samo4/PD-sniffer-237-remix/hw/FreshTwinkie.kicad_pcb

## KiCad design hw/FreshTwinkie.kicad_pcb (2023-12-09)

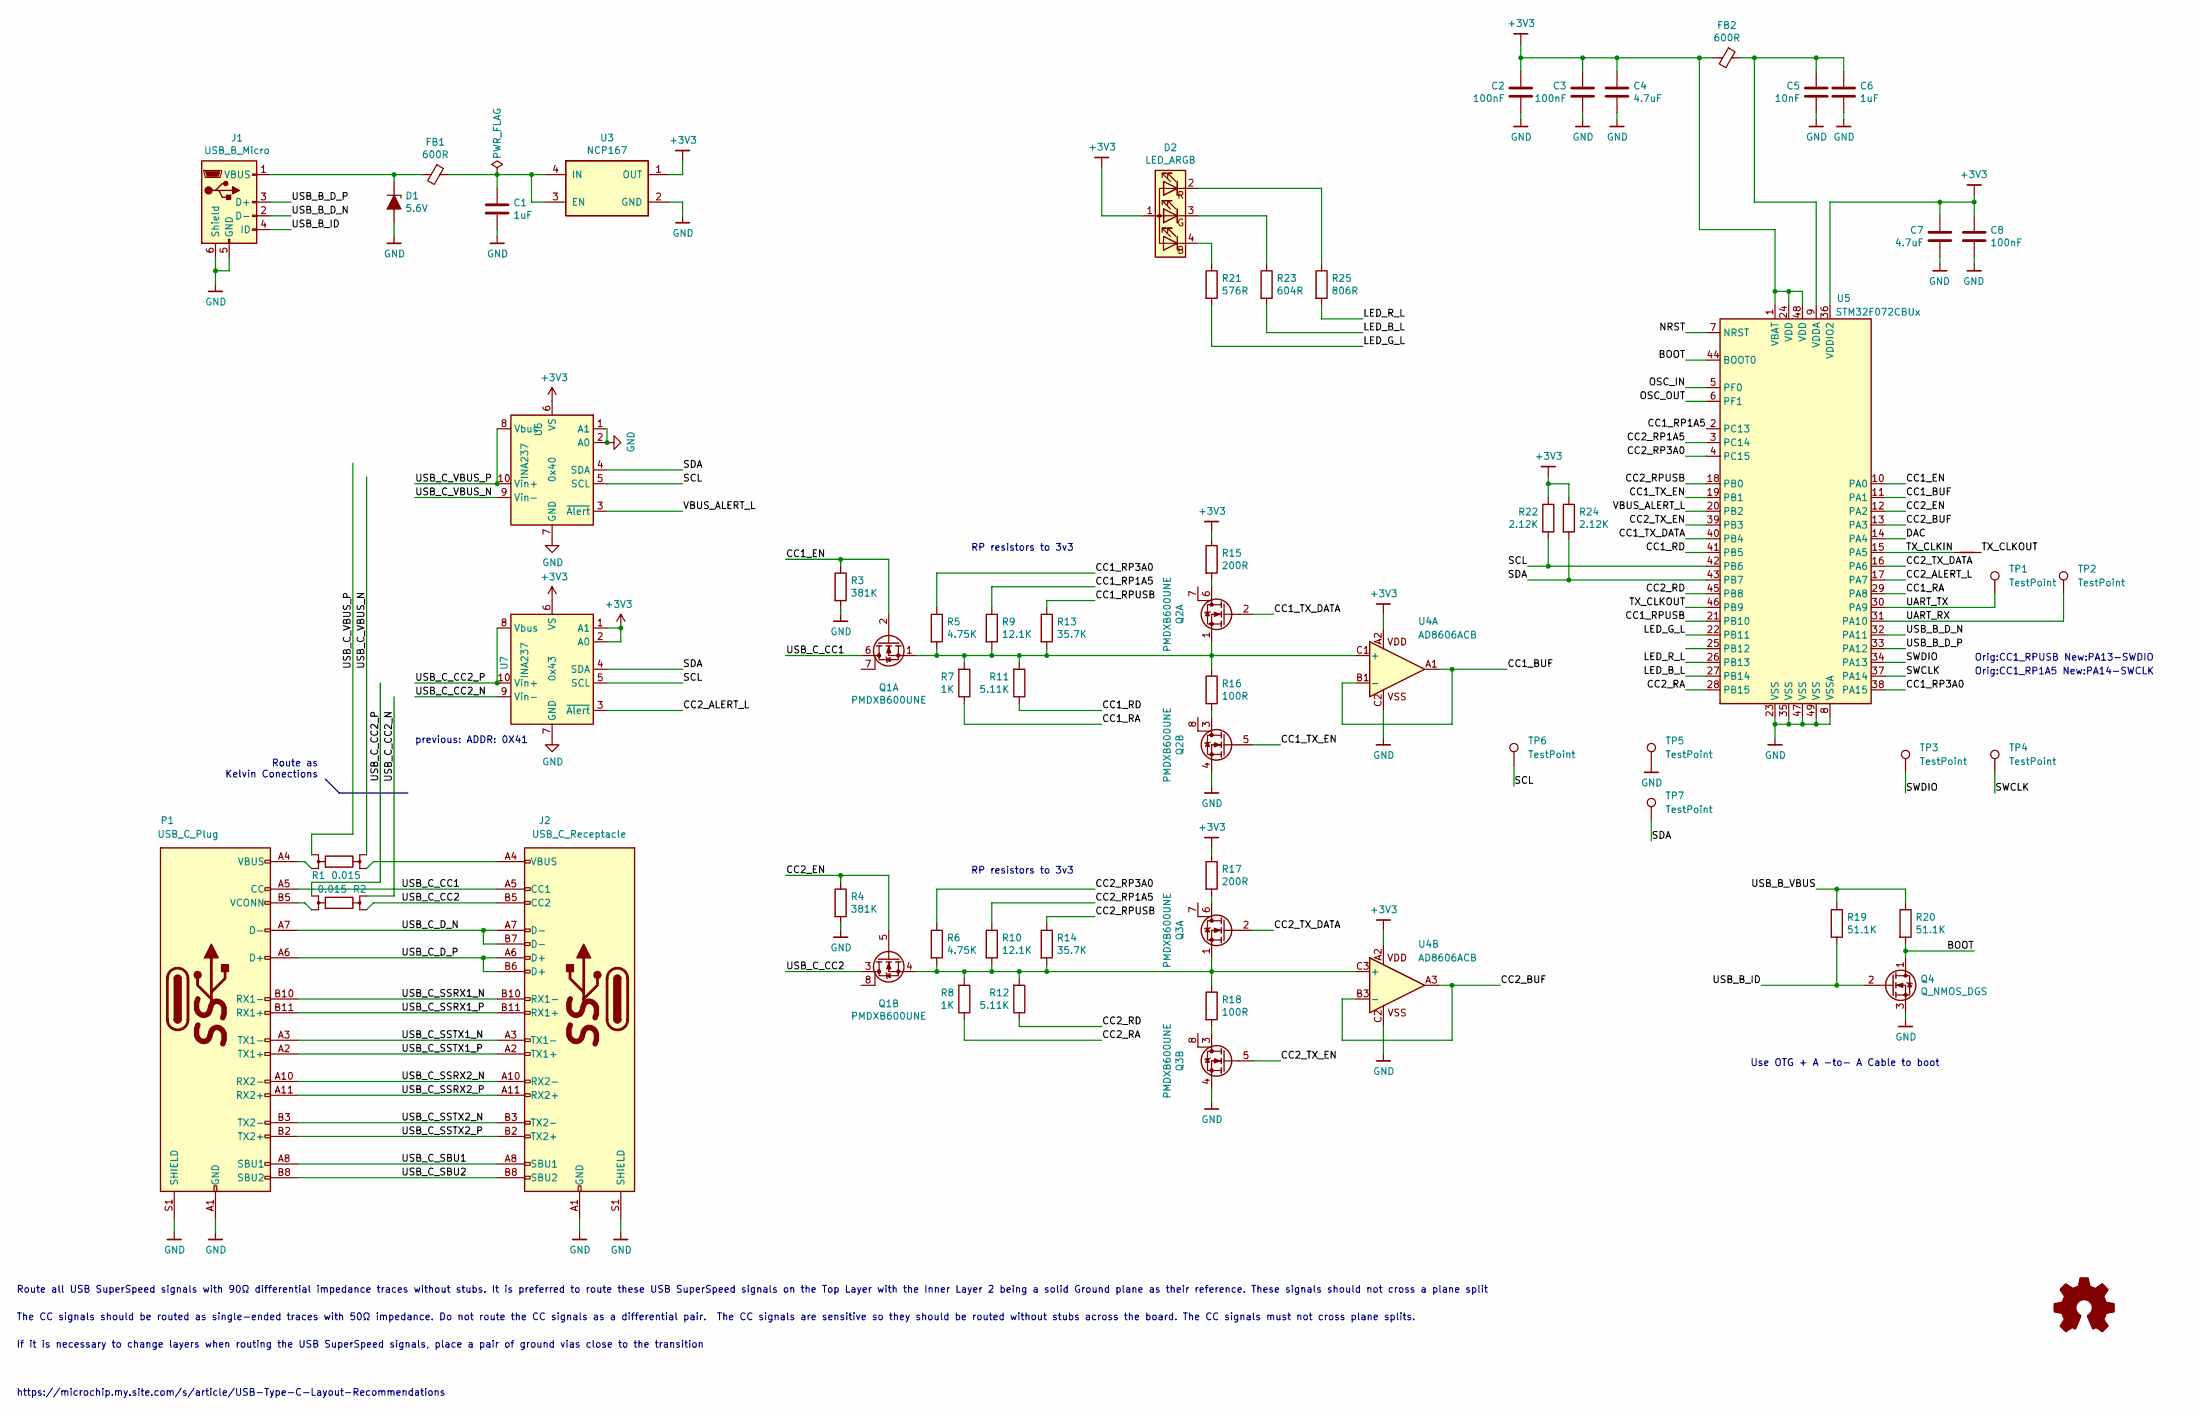
[picture p1: schematic FreshTwinkie.kicad_sch, ClockClock Module]

Parts:
C1, C6: 1uF; C_0402
C2, C3, C8: 100nF; C_0201
C4, C7: 4.7uF; C_0402
C5: 10nF; C_0201
D1: 5.6V; D_0402_1005Metric
D2: LED_ARGB; 0404LED_RGB
FB1, FB2: 600R; L_0402
J1: USB_B_Micro; USB_Micro-B_GCT_USB3076-30-A
J2: USB_C_Receptacle; USB_C_Receptacle_Amphenol_12401610E4-2A
NT1: Net-Tie_2; NetTie-2_SMD_Pad0.5mm
P1: USB_C_Plug; USB_C_Plug_Molex_105444
Q1, Q2, Q3: PMDXB600UNE; DFN1010B-6 (SOT1216)
Q4: Q_NMOS_DGS; MOSFET_1.0x0.6mm
R1, R2: 0.015; 4W_R_1206
R3, R4: 381K; R_0201
R5, R6: 4.75K; R_0201
R7, R8: 1K; R_0201
R9, R10: 12.1K; R_0201
R11, R12: 5.11K; R_0201
R13, R14: 35.7K; R_0201
R15, R17: 200R; R_0201
R16, R18: 100R; R_0201
R19, R20: 51.1K; R_0201
R21: 576R; R_0201
R22, R24: 2.12K; R_0201
R23: 604R; R_0201
R25: 806R; R_0201
TP1, TP2, TP3, TP4, TP5, TP6, TP7: TestPoint; TestPoint_Pad_D1.0mm
U3: NCP167; X2SON_4_1.0x1.0mm
U4: AD8606ACB; WLCSP-8 3X3_0.5
U5: STM32F072CBUx; QFN-48-1EP_7x7mm_P0.5mm_EP5.6x5.6mm
U6, U7: INA237; VSSOP-10_3x3mm_P0.5mm; Mfg P/N INA237AIDGSR; DigiKey P/N 296-INA237AIDGSRCT-ND

Connections:
+3V3: C2.1, C3.1, C4.1, C7.1, C8.1, D2.1 (A), FB2.2, R15.1, R17.1, R22.1, R24.1, U3.1 (OUT), U4.A2, U5.1 (VBAT), U5.24 (VDD), U5.36 (VDDIO2), U5.48 (VDD), U6.6 (VS), U7.1 (A1), U7.2 (A0), U7.6 (VS)
/BOOT: Q4.1 (D), R20.2, U5.44 (BOOT0)
/CC1_BUF: U4.A1, U4.B1 (-), U5.11 (PA1)
/CC1_EN: Q1.2 (G), R3.1, U5.10 (PA0)
/CC1_RA: R7.1, U5.29 (PA8)
/CC1_RD: R11.1, U5.41 (PB5)
/CC1_RP1A5: R9.1, U5.2 (PC13)
/CC1_RP3A0: R5.1, U5.38 (PA15)
/CC1_RPUSB: R13.1, U5.21 (PB10)
/CC1_TX_DATA: Q2.2 (G), U5.40 (PB4)
/CC1_TX_EN: Q2.5 (G), U5.19 (PB1)
/CC2_ALERT_L: U5.17 (PA7), U7.3 (~Alert)
/CC2_BUF: U4.A3, U4.B3 (-), U5.13 (PA3)
/CC2_EN: Q1.5 (G), R4.1, U5.12 (PA2)
/CC2_RA: R8.1, U5.28 (PB15)
/CC2_RD: R12.1, U5.45 (PB8)
/CC2_RP1A5: R10.1, U5.3 (PC14)
/CC2_RP3A0: R6.1, U5.4 (PC15)
/CC2_RPUSB: R14.1, U5.18 (PB0)
/CC2_TX_DATA: Q3.2 (G), U5.16 (PA6)
/CC2_TX_EN: Q3.5 (G), U5.39 (PB3)
/DAC: U5.14 (PA4)
/LED_B_L: R23.2, U5.27 (PB14)
/LED_G_L: R21.2, U5.22 (PB11)
/LED_R_L: R25.2, U5.26 (PB13)
/NRST: U5.7 (NRST)
/OSC_IN: U5.5 (PF0)
/OSC_OUT: U5.6 (PF1)
/SCL: R22.2, TP6.1, U5.42 (PB6), U6.5 (SCL), U7.5 (SCL)
/SDA: R24.2, TP7.1, U5.43 (PB7), U6.4 (SDA), U7.4 (SDA)
/SWCLK: TP4.1, U5.37 (PA14)
/SWDIO: TP3.1, U5.34 (PA13)
/TX_CLKIN: NT1.1, U5.15 (PA5)
/TX_CLKOUT: NT1.2, U5.46 (PB9)
/UART_RX: TP2.1, U5.31 (PA10)
/UART_TX: TP1.1, U5.30 (PA9)
/USB_B_D_N: J1.2 (D-), U5.32 (PA11)
/USB_B_D_P: J1.3 (D+), U5.33 (PA12)
/USB_B_ID: J1.4 (ID), Q4.2 (G), R19.2
/USB_B_VBUS: R19.1, R20.1
/USB_C_CC1: J2.A5 (CC1), P1.A5 (CC), Q1.6 (D)
/USB_C_CC2: J2.B5 (CC2), Q1.3 (D), R2.1
/USB_C_CC2_N: R2.3, U7.9 (Vin-)
/USB_C_CC2_P: R2.4, U7.8 (Vbus), U7.10 (Vin+)
/USB_C_D_N: J2.A7 (D-), J2.B7 (D-), P1.A7 (D-)
/USB_C_D_P: J2.A6 (D+), J2.B6 (D+), P1.A6 (D+)
/USB_C_SBU1: J2.A8 (SBU1), P1.A8 (SBU1)
/USB_C_SBU2: J2.B8 (SBU2), P1.B8 (SBU2)
/USB_C_SSRX1_N: J2.B10 (RX1-), P1.B10 (RX1-)
/USB_C_SSRX1_P: J2.B11 (RX1+), P1.B11 (RX1+)
/USB_C_SSRX2_N: J2.A10 (RX2-), P1.A10 (RX2-)
/USB_C_SSRX2_P: J2.A11 (RX2+), P1.A11 (RX2+)
/USB_C_SSTX1_N: J2.A3 (TX1-), P1.A3 (TX1-)
/USB_C_SSTX1_P: J2.A2 (TX1+), P1.A2 (TX1+)
/USB_C_SSTX2_N: J2.B3 (TX2-), P1.B3 (TX2-)
/USB_C_SSTX2_P: J2.B2 (TX2+), P1.B2 (TX2+)
/USB_C_VBUS_N: R1.3, U6.9 (Vin-)
/USB_C_VBUS_P: R1.4, U6.8 (Vbus), U6.10 (Vin+)
/VBUS_ALERT_L: U5.20 (PB2), U6.3 (~Alert)
GND: C1.2, C2.2, C3.2, C4.2, C5.2, C6.2, C7.2, C8.2, D1.2 (A), J1.5 (GND), J1.6 (Shield), J2.A1 (GND), J2.A12 (GND), J2.B1 (GND), J2.B12 (GND), J2.S1 (SHIELD), P1.A1 (GND), P1.A12 (GND), P1.B1 (GND), P1.B12 (GND), P1.S1 (SHIELD), Q2.4 (S), Q3.4 (S), Q4.3 (S), R3.2, R4.2, TP5.1, U3.2 (GND), U4.C2, U5.8 (VSSA), U5.23 (VSS), U5.35 (VSS), U5.47 (VSS), U5.49 (VSS), U6.1 (A1), U6.2 (A0), U6.7 (GND), U7.7 (GND)
unnamed: D1.1 (K), FB1.2, J1.1 (VBUS)
unnamed: D2.4 (BK), R21.1
unnamed: D2.3 (GK), R23.1
unnamed: D2.2 (RK), R25.1
unnamed: J2.A4 (VBUS), J2.A9 (VBUS), J2.B4 (VBUS), J2.B9 (VBUS), R1.1
unnamed: P1.A4 (VBUS), P1.A9 (VBUS), P1.B4 (VBUS), P1.B9 (VBUS), R1.2
unnamed: P1.B5 (VCONN), R2.2
unnamed: Q1.1 (S), Q2.1 (S), R5.2, R7.2, R9.2, R11.2, R13.2, R16.1, U4.C1 (+)
unnamed: Q1.4 (S), Q3.1 (S), R6.2, R8.2, R10.2, R12.2, R14.2, R18.1, U4.C3 (+)
unnamed: Q2.6 (D), R15.2
unnamed: Q2.3 (D), R16.2
unnamed: Q3.6 (D), R17.2
unnamed: Q3.3 (D), R18.2
unnamed: C1.1, FB1.1, U3.3 (EN), U3.4 (IN)
unnamed: C5.1, C6.1, FB2.1, U5.9 (VDDA)

Notes on the sheet:
Orig:CC1_RPUSB New:PA13-SWDIO
Orig:CC1_RP1A5 New:PA14-SWCLK
RP resistors to 3v3
Route as Kelvin Conections
https://microchip.my.site.com/s/article/USB-Type-C-Layout-Recommendations
Use OTG + A -to- A Cable to boot
previous: ADDR: 0X41
The CC signals should be routed as single-ended traces with 50Ω impedance. Do not route the CC signals as a differential pair. The CC signals are sensitive so they should be routed without stubs across the board. The CC signals must not cross plane splits.
Route all USB SuperSpeed signals with 90Ω differential impedance traces without stubs. It is preferred to route these USB SuperSpeed signals on the Top Layer with the Inner Layer 2 being a solid Ground plane as their reference. These signals should not cross a plane split
If it is necessary to change layers when routing the USB SuperSpeed signals, place a pair of ground vias close to the transition

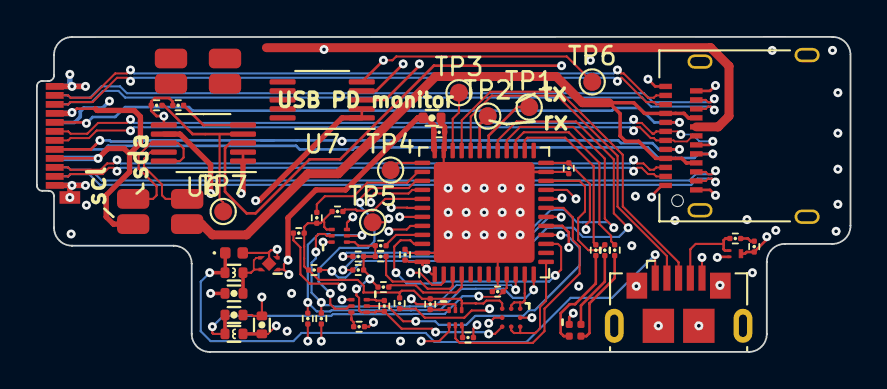
[picture p2: board FreshTwinkie.kicad_pcb from above]

Board: 6 copper layers, 45.2 x 17.5 mm, 57 parts (1 on the bottom side), 71 nets.
