samo4/PD-sniffer-237-remix/(commit log)

2023-12-08 initial remix
    [FreshTwinkie.csv, FreshTwinkie.kicad_pcb, FreshTwinkie.kicad_sch]
2023-12-09 wip with rules, 6 layer
    [FreshTwinkie.kicad_pcb, FreshTwinkie.kicad_sch, FreshTwinkie.sch, FreshTwinkie_v0.1_panel.kicad_pcb]
